Markneoneo/ALEX-Project/(commit log)

2024-03-31 Removed Past Code, Integrated Color Sensor Code
2024-03-31 Moved color sensor code
2024-03-31 Changed name to color-sensor
2024-04-08 Added Ultrasonic Folder
2024-04-08 Add files via upload
    Add Ultrasonic Sensor code
2024-04-08 Delete Ultrasonic/Test.txt
    Remove Placeholder
2024-04-08 Updated with fixed movement from keys
    Updated just the w key to move forward at 50cm 100% power
    [alex-pi.cpp]
2024-04-08 Added left() and right() for movement
    Included the left() and right() which calls ccw() and cw() cos it was missing in the code which caused the turn movements to not work at all
    [Alex.ino]
2024-04-09 Update color-sensor.ino
    Changed from detecting RGB to RGOthers
2024-04-09 Update ultrasonic to new arduino
2024-04-09 Updated Color Sensor to detect white
2024-04-09 Create ArduinoUNO.ino
    Arduino UNO placeholder
2024-04-09 Update Alex.ino
    Removed Color Sensor data and code
2024-04-09 Renamed ArduinoUNO
2024-04-09 Delete ArduinoUNO.ino
    removed
2024-04-09 Update robotlib.ino
    Updated code does not work for forwards but backwards work
    [robotlib.ino]
2024-04-09 Update Alex.ino
    Removed Color sensor
2024-04-09 Update constants.h
    FIXED MOVEMENT (i think)
    [constants.h]
2024-04-10 Updated the left and right movement
    Left and right movement now works upon command, but currently turns infinitely
2024-04-10 Update ArduinoUNO.ino for serialComms
2024-04-10 Update color-sensor.ino for serialComms
2024-04-10 Update ultrasonic.ino for serialComms
2024-04-10 Using analog pins for ultrasonic
2024-04-10 Update tcp_server.cpp
    edited to reduce buffer size.
    code here is for testing of TCP server without connection to arduino
2024-04-11 Add files via upload
    SPI
2024-04-11 Update ultrasonic.ino
    Labelled Sensors
2024-04-11 Updated for SPI
2024-04-13 Updated SPI
2024-04-15 Goated updates for SPI
2024-04-15 Goated SPI update
2024-04-21 Add new baremetal code for motor and Alex.ino
